benjaminbra/FlyingCableCar/(commit log)

2019-06-14 Adding nitro control and Camera/Servo control
2019-06-21 Fix servo angles and improvements of the default command
    [RadioSpyCar.ino]
